MuhammadNabilRaihan16523191/low-power-12b-first-order-delta-sigma-adc/src/layout/dac_1bit/dac_1bit_minus/DAC_1_BIT_MIN.spice

** sch_path: /foss/designs/schematics/dac_1bit/DAC_1_BIT_MIN.sch
.subckt DAC_1_BIT_MIN VDD VSS VIN VREFP VREFN VOUT
.param Ld=0.28u Wsp_m=5u Wsn_m=0.5u Wdp_m=10u Wdn_m=1u
*.ipin VIN
*.ipin VREFP
*.ipin VREFN
*.opin VOUT
*.ipin VDD
*.ipin VSS
XM1 net1 net2 VREFP VSS nfet_03v3 L=Ld W=Wdn_m nf=2 ad='int((nf+1)/2) * W/nf * 0.18u' as='int((nf+2)/2) * W/nf * 0.18u' pd='2*int((nf+1)/2) * (W/nf + 0.18u)'
+ ps='2*int((nf+2)/2) * (W/nf + 0.18u)' nrd='0.18u / W' nrs='0.18u / W' sa=0 sb=0 sd=0 m=1
XM2 net1 VIN VREFP VDD pfet_03v3 L=Ld W=Wdp_m nf=2 ad='int((nf+1)/2) * W/nf * 0.18u' as='int((nf+2)/2) * W/nf * 0.18u' pd='2*int((nf+1)/2) * (W/nf + 0.18u)'
+ ps='2*int((nf+2)/2) * (W/nf + 0.18u)' nrd='0.18u / W' nrs='0.18u / W' sa=0 sb=0 sd=0 m=1
XM3 net1 VIN VREFN VSS nfet_03v3 L=Ld W=Wdn_m nf=2 ad='int((nf+1)/2) * W/nf * 0.18u' as='int((nf+2)/2) * W/nf * 0.18u' pd='2*int((nf+1)/2) * (W/nf + 0.18u)'
+ ps='2*int((nf+2)/2) * (W/nf + 0.18u)' nrd='0.18u / W' nrs='0.18u / W' sa=0 sb=0 sd=0 m=1
XM4 net1 net2 VREFN VDD pfet_03v3 L=Ld W=Wdp_m nf=2 ad='int((nf+1)/2) * W/nf * 0.18u' as='int((nf+2)/2) * W/nf * 0.18u' pd='2*int((nf+1)/2) * (W/nf + 0.18u)'
+ ps='2*int((nf+2)/2) * (W/nf + 0.18u)' nrd='0.18u / W' nrs='0.18u / W' sa=0 sb=0 sd=0 m=1
XM5 net2 VIN VDD VDD pfet_03v3 L=Ld W=Wsp_m nf=1 ad='int((nf+1)/2) * W/nf * 0.18u' as='int((nf+2)/2) * W/nf * 0.18u' pd='2*int((nf+1)/2) * (W/nf + 0.18u)'
+ ps='2*int((nf+2)/2) * (W/nf + 0.18u)' nrd='0.18u / W' nrs='0.18u / W' sa=0 sb=0 sd=0 m=1
XM6 net2 VIN VSS VSS nfet_03v3 L=Ld W=Wsn_m nf=1 ad='int((nf+1)/2) * W/nf * 0.18u' as='int((nf+2)/2) * W/nf * 0.18u' pd='2*int((nf+1)/2) * (W/nf + 0.18u)'
+ ps='2*int((nf+2)/2) * (W/nf + 0.18u)' nrd='0.18u / W' nrs='0.18u / W' sa=0 sb=0 sd=0 m=1
XM7 VOUT net1 VDD VDD pfet_03v3 L=Ld W=Wsp_m nf=1 ad='int((nf+1)/2) * W/nf * 0.18u' as='int((nf+2)/2) * W/nf * 0.18u' pd='2*int((nf+1)/2) * (W/nf + 0.18u)'
+ ps='2*int((nf+2)/2) * (W/nf + 0.18u)' nrd='0.18u / W' nrs='0.18u / W' sa=0 sb=0 sd=0 m=1
XM8 VOUT net1 VSS VSS nfet_03v3 L=Ld W=Wsn_m nf=1 ad='int((nf+1)/2) * W/nf * 0.18u' as='int((nf+2)/2) * W/nf * 0.18u' pd='2*int((nf+1)/2) * (W/nf + 0.18u)'
+ ps='2*int((nf+2)/2) * (W/nf + 0.18u)' nrd='0.18u / W' nrs='0.18u / W' sa=0 sb=0 sd=0 m=1

.include /foss/pdks/gf180mcuD/libs.tech/ngspice/design.ngspice
.lib /foss/pdks/gf180mcuD/libs.tech/ngspice/sm141064.ngspice typical
.lib /foss/pdks/gf180mcuD/libs.tech/ngspice/smbb000149.ngspice typical

.ends DAC_1_BIT_MIN
.end
