MuhammadNabilRaihan16523191/low-power-12b-first-order-delta-sigma-adc/(commit log)

2026-07-22 Feat: add analog integration version2
    [analog_integration_v2.sch]
2026-07-25 feat refined simulation
    [analog_integration.sch, diffamp_integ_integration_tran_tb.sch, fullydiffamp_tb_ac.sch, fullydiffamp_tb_tran.sch]
2026-07-25 Feat: analog integration v3 and v4
    -Changing analog integration v2 to include 300 kHz passive lpf rc filter and just diffamp+integrator
    -Added analog integration v3 to include comparator and CF=300 pF
    -Added analog integration v4 like v3 with CF=50pF
    -Needed comparator output be good before updating to v5
    [analog_integration_v2.sch, analog_integration_v3.sch, analog_integration_v4.sch]
2026-07-25 - Updated on Integration Schematics
    [analog_integration_v5.sch]
2026-07-26 Analog Integration V7, V8
    [analog_integration_v7_dac_min.sch, analog_integration_v8_dac_plus.sch]
2026-07-26 Update on Integration & DAC
    - Integrated Diffamp, Integrator, Comparator, and DAC+ & DAC-
    - Updated Sch of DAC+, DAC-, both symbols for integration
    [DAC_1_BIT_MIN.sch, DAC_1_BIT_PLUS.sch, analog_integration_v10.sch]
2026-07-28 Penambahan sistem non-overlapping clock dan clock untuk cic filter
2026-07-30 feat add refined FDA simulation script
    [fullydiffamp_tb_ac.sch, fullydiffamp_tb_tran.sch]
2026-07-30 feat add refined FDA tran simulation script
    [fullydiffamp_tb_tran.sch]
2026-08-10 Update analog_integration_v10
    [analog_integration_v10.sch]
2026-08-10 Add Integrator Layout
    [integrator.sch]
2026-08-11 Feat: layout folder refactor and intgerator schematics update
    - Layout folder for dac 1bit min refactored
    - Add integrator first order layout folder and move its relevant files to there
    - Change integrator first order schematic
    [integrator.sch]
2026-08-15 Update Diff Amp and Integration V10
    [analog_integration_v10.sch, fullydiffamp.sch, fullydiffamp_tb_ac_sine.sch, fullydiffamp_tb_tran_pulse.sch, fullydiffamp_tb_tran_sine.sch, fullydiffamp_tb_tran_triangular.sch]
